jaschawilcox/card-io-hw/frontend/production/frontend_2024-02-06_21-15-05/bom.csv

Designator | Footprint | Quantity | Value | LCSC Part #
C1, C10, C3 | 0603 | 3 | 100n
C11, C12, C13, C14, C15, C17 | 0603 | 6 | 100p
C16 | 0603 | 1 | 1.5n
C2, C4, C7, C8 | 0603 | 4 | 1u
C5, C6 | 0603 | 2 | 4.7n
C9 | 0805 | 1 | 10u
Q1, Q4, Q6 | SOT-23 | 3 | T2N7002AK,LM
Q2, Q3, Q5 | SOT-23 | 3 | NX3008PBK,215
R1, R2, R5, R6 | 0603 | 4 | 2k
R10, R11, R12, R13, R14, R16, R3, R4, R8, R9 | 0603 | 10 | 1M
R15, R7 | 0603 | 2 | 0R
U1 | ADS1291-2 | 1 | ADS1291/2
U2 | KC2016Z | 1 | KC2016Z2
