jaschawilcox/card-io-hw/main_board/main_board.kicad_pcb

## KiCad design main_board/main_board.kicad_pcb (2024-02-07)

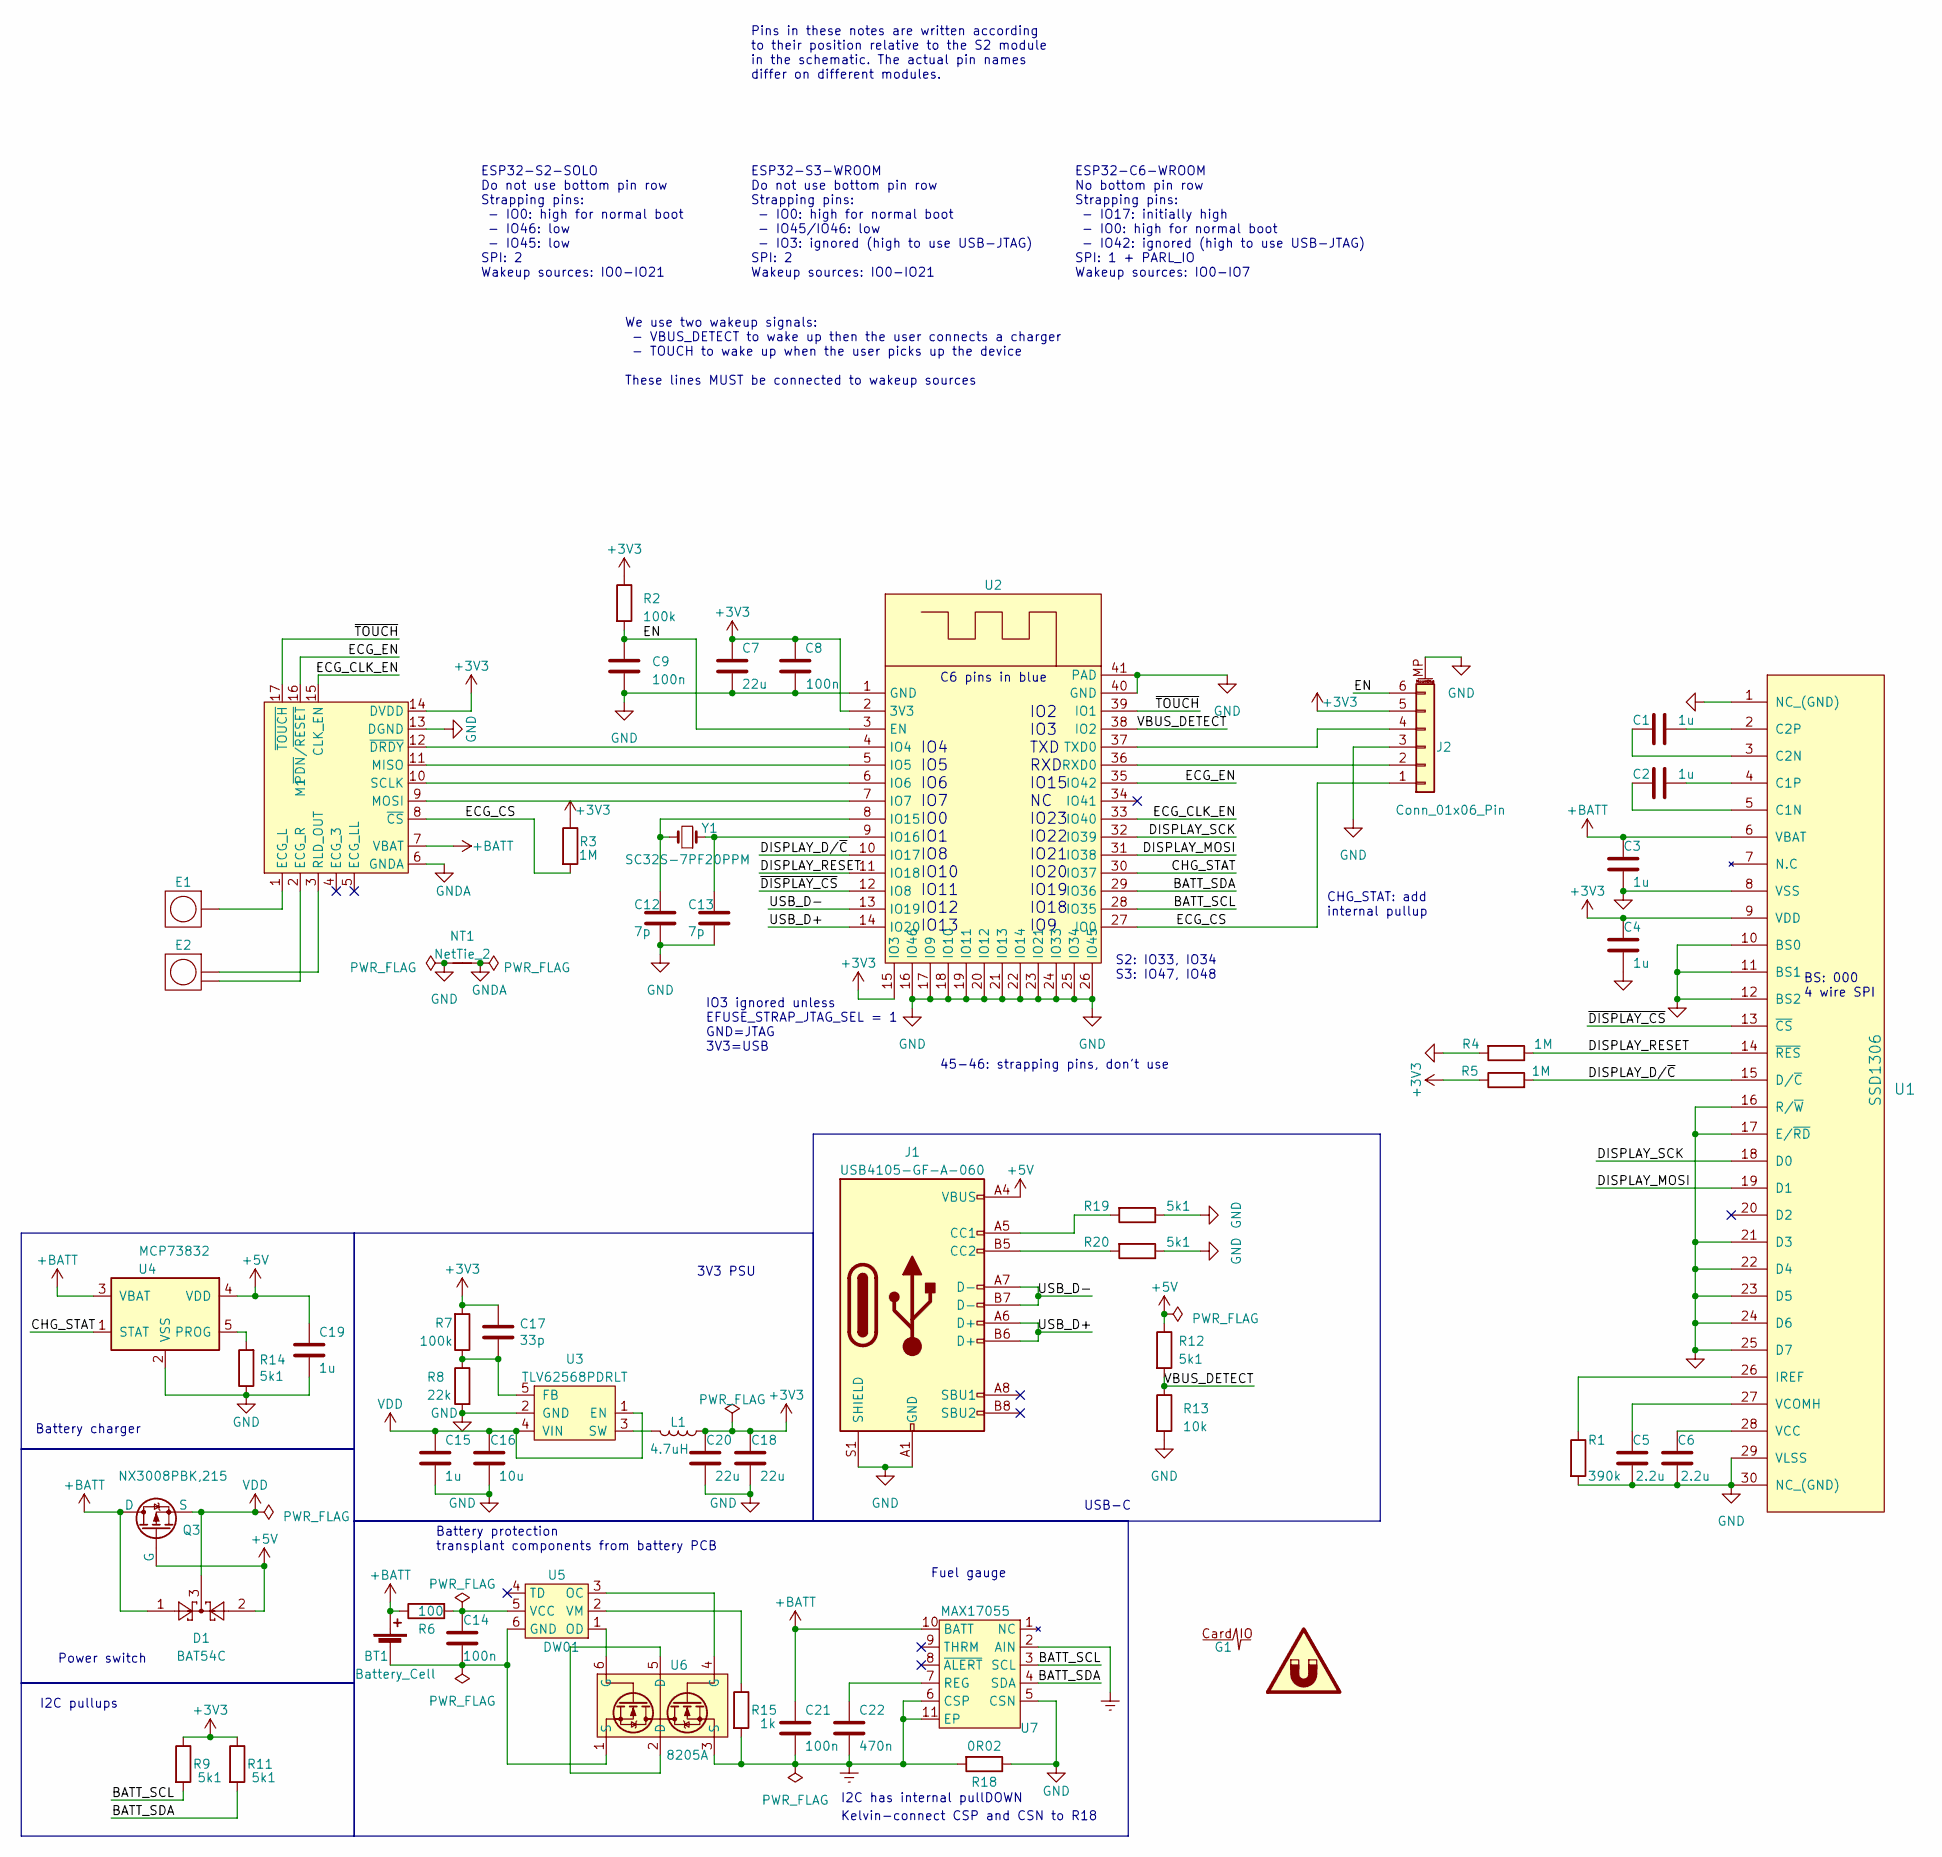
[picture p1: schematic main_board.kicad_sch, Card/IO ECG main board]

Parts:
BT1: Battery_Cell; Battery_transplant
C1, C2, C3, C4, C15, C19: 1u; C_0603_1608Metric; MPN CC0603KRX7R6BB105; LCSC Part # C113807
C5, C6: 2.2u; C_0603_1608Metric; MPN CC0603ZRY5V6BB225; LCSC Part # C106849
C7, C18, C20: 22u; C_0805_2012Metric; MPN CC0603MRX5R6BB226; LCSC Part # C109447
C8, C9, C14, C21: 100n; C_0603_1608Metric; MPN AC0603KRX7R0BB104; LCSC Part # C408909
C12, C13: 7p; C_0603_1608Metric; MPN CC0603DRNPO9BN7R0; LCSC Part # C513583
C16: 10u; C_0603_1608Metric; MPN JMK107ABJ106MA-T; LCSC Part # C268008
C17: 33p; C_0603_1608Metric; MPN CC0603JRNPO9BN330; LCSC Part # C107047
C22: 470n; C_0603_1608Metric; MPN CC0603JRX7R7BB474; LCSC Part # C519558
D1: BAT54C; SOT-23; MPN BAT54C; LCSC Part # C171429
E1: Electrode
E2: SplitElectrode
G1: logo
J1: USB4105-GF-A-060; USB_C_Receptacle_GCT_USB4105-xx-A_16P_TopMnt_Horizontal; MPN USB-TYPE-C-018; LCSC Part # C2927038
J2: Conn_01x06_Pin; Molex_Pico-Clasp_501331-0607_1x06-1MP_P1.00mm_Vertical; MPN 5013310607; LCSC Part # C587861
L1: 4.7uH; TYA40124R7M-10; MPN TYA40124R7M-10; LCSC Part # C2649049
M1: ECG-module_1lead
NT1: NetTie_2; NetTie-2_SMD_Pad2.0mm
Q3: NX3008PBK,215; SOT-23; MPN NX3008PBK,215; LCSC Part # C131670
QR1: SYM_Magnet_Large; website-qr
R1: 390k; R_0603_1608Metric; MPN RC0603FR-07390KL; LCSC Part # C137735
R2, R7: 100k; R_0603_1608Metric; MPN RC0603JR-07100KL; LCSC Part # C100048
R3, R4, R5: 1M; R_0603_1608Metric; MPN RT0603DRD071ML; LCSC Part # C482623
R6: 100; R_0603_1608Metric; MPN RT0603BRD07100RL; LCSC Part # C122970
R8: 22k; R_0603_1608Metric; MPN RC0603FR-0722KL; LCSC Part # C114065
R9, R11, R12, R14, R19, R20: 5k1; R_0603_1608Metric; MPN RT0603FRE075K1L; LCSC Part # C706184
R13: 10k; R_0603_1608Metric; MPN RT0603BRD0710KL; LCSC Part # C95204
R15: 1k; R_0603_1608Metric; MPN RT0603FRE071KL; LCSC Part # C375503
R18: 0R02; R_0603_1608Metric; MPN PE0603FRF570R02L; LCSC Part # C1730619
U1: SSD1306
U2: ESP32-S2-SOLO; MPN ESP32-S2-SOLO-2-N4; LCSC Part # C3040594
U3: TLV62568PDRLT; SOT-23-5; MPN TLV62568PDRLT; LCSC Part # C2071727
U4: MCP73832; SOT-23-5; MPN MCP73832T-2ACI/OT; LCSC Part # C38066
U5: DW01; SOT-23-6; MPN DW01; LCSC Part # C917079
U6: 8205A; SOT-23-6; MPN 8205A; LCSC Part # C2762931
U7: MAX17055; MPN MAX17055ETB+; LCSC Part # C402925
Y1: SC32S-7PF20PPM; Crystal_SMD_MicroCrystal_CC7V-T1A-2Pin_3.2x1.5mm; MPN SC32S-7PF20PPM; LCSC Part # C5452100

Connections:
+3V3: C4.2, C7.1, C8.1, C17.1, C18.1, C20.1, J2.5, L1.1, M1.14 (DVDD), R2.1, R3.1, R5.1, R7.2, R9.1, R11.1, U1.9 (VDD), U2.2 (3V3), U2.15 (IO3)
+5V: C19.1, D1.2, J1.A4 (VBUS), J1.A9 (VBUS), J1.B4 (VBUS), J1.B9 (VBUS), Q3.1 (G), R12.1, U4.4 (VDD)
+BATT: BT1.1 (+), C3.2, C21.1, D1.1, M1.7 (VBAT), Q3.3 (D), R6.1, U1.6 (VBAT), U4.3 (VBAT), U7.10 (BATT)
/BATT_SCL: R9.2, U2.28 (IO35), U7.3 (SCL)
/BATT_SDA: R11.2, U2.29 (IO36), U7.4 (SDA)
/CHG_STAT: U2.30 (IO37), U4.1 (STAT)
/DISPLAY_D/~C: R5.2, U1.15 (D/~C), U2.10 (IO17)
/DISPLAY_MOSI: U1.19 (D1), U2.31 (IO38)
/DISPLAY_RESET: R4.1, U1.14 (~RES), U2.11 (IO18)
/DISPLAY_SCK: U1.18 (D0), U2.32 (IO39)
/ECG_CLK_EN: M1.15 (CLK_EN), U2.33 (IO40)
/ECG_CS: J2.1, M1.8 (~CS), R3.2, U2.27 (IO0)
/ECG_EN: M1.16 (~PDN/~RESET), U2.35 (IO42)
/EN: C9.1, J2.6, R2.2, U2.3 (EN)
/USB_D+: J1.A6 (D+), J1.B6 (D+), U2.14 (IO20)
/USB_D-: J1.A7 (D-), J1.B7 (D-), U2.13 (IO19)
/VBUS_DETECT: R12.2, R13.1, U2.38 (IO2)
/~DISPLAY_CS: U1.13 (~CS), U2.12 (IO8)
/~TOUCH: M1.17 (~TOUCH), U2.39 (IO1)
Earth: C21.2, C22.2, R15.2, R18.2, U6.3 (S), U7.2 (AIN), U7.6 (CSP), U7.11 (EP)
GND: C3.1, C4.1, C5.1, C6.1, C7.2, C8.2, C9.2, C12.1, C13.1, C15.2, C16.2, C18.2, C19.2, C20.2, J1.A1 (GND), J1.A12 (GND), J1.B1 (GND), J1.B12 (GND), J1.S1 (SHIELD), J2.3, J2.MP (MountPin), M1.13 (DGND), NT1.1, R1.2, R4.2, R8.2, R13.2, R14.1, R18.1, R19.1, R20.1, U1.1 (NC_(GND)), U1.8 (VSS), U1.10 (BS0), U1.11 (BS1), U1.12 (BS2), U1.16 (R/~W), U1.17 (E/~RD), U1.21 (D3), U1.22 (D4), U1.23 (D5), U1.24 (D6), U1.25 (D7), U1.29 (VLSS), U1.30 (NC_(GND)), U2.1 (GND), U2.16 (IO46), U2.17 (IO9), U2.18 (IO10), U2.19 (IO11), U2.20 (IO12), U2.21 (IO13), U2.22 (IO14), U2.23 (IO21), U2.24 (IO33), U2.25 (IO34), U2.26 (IO45), U2.40 (GND), U2.41 (PAD), U3.2 (GND), U4.2 (VSS), U7.5 (CSN)
GNDA: M1.6 (GNDA), NT1.2
unnamed: BT1.2 (-), C14.2, U5.6 (GND), U6.1 (S)
unnamed: J1.A5 (CC1), R19.2
unnamed: J1.B5 (CC2), R20.2
unnamed: J2.2, U2.36 (RXD0)
unnamed: J2.4, U2.37 (TXD0)
unnamed: E1.1, M1.1 (ECG_L)
unnamed: E2.2, M1.2 (ECG_R)
unnamed: M1.11 (MISO), U2.5 (IO5)
unnamed: M1.9 (MOSI), U2.7 (IO7)
unnamed: E2.1, M1.3 (RLD_OUT)
unnamed: M1.10 (SCLK), U2.6 (IO6)
unnamed: M1.12 (~DRDY), U2.4 (IO4)
unnamed: C2.1, U1.5 (C1N)
unnamed: C2.2, U1.4 (C1P)
unnamed: C1.1, U1.3 (C2N)
unnamed: C1.2, U1.2 (C2P)
unnamed: R1.1, U1.26 (IREF)
unnamed: C6.2, U1.28 (VCC)
unnamed: C5.2, U1.27 (VCOMH)
unnamed: C12.2, U2.8 (IO15), Y1.2
unnamed: C13.2, U2.9 (IO16), Y1.1
unnamed: C17.2, R7.1, R8.1, U3.5 (FB)
unnamed: L1.2, U3.3 (SW)
unnamed: R14.2, U4.5 (PROG)
unnamed: U5.3 (OC), U6.4 (G)
unnamed: U5.1 (OD), U6.6 (G)
unnamed: C14.1, R6.2, U5.5 (VCC)
unnamed: R15.1, U5.2 (VM)
unnamed: U6.2 (D), U6.5 (D)
unnamed: C22.1, U7.7 (REG)
VDD: C15.1, C16.1, D1.3, Q3.2 (S), U3.1 (EN), U3.4 (VIN)

Notes on the sheet:
IO2 IO3 TXD RXD IO15 NC IO23 IO22 IO21 IO20 IO19 IO18 IO9
IO4 IO5 IO6 IO7 IO0 IO1 IO8 IO10 IO11 IO12 IO13
We use two wakeup signals: - VBUS_DETECT to wake up then the user connects a charger - TOUCH to wake up when the user picks up the device These lines MUST be connected to wakeup sources
C6 pins in blue
USB-C
ESP32-C6-WROOM No bottom pin row Strapping pins: - IO17: initially high - IO0: high for normal boot - IO42: ignored (high to use USB-JTAG) SPI: 1 + PARL_IO Wakeup sources: IO0-IO7
Kelvin-connect CSP and CSN to R18
ESP32-S3-WROOM Do not use bottom pin row Strapping pins: - IO0: high for normal boot - IO45/IO46: low - IO3: ignored (high to use USB-JTAG) SPI: 2 Wakeup sources: IO0-IO21
Battery charger
ESP32-S2-SOLO Do not use bottom pin row Strapping pins: - IO0: high for normal boot - IO46: low - IO45: low SPI: 2 Wakeup sources: IO0-IO21
CHG_STAT: add internal pullup
Pins in these notes are written according to their position relative to the S2 module in the schematic. The actual pin names differ on different modules.
Fuel gauge
3V3 PSU
BS: 000 4 wire SPI
45-46: strapping pins, don't use
I2C has internal pullDOWN
Battery protection transplant components from battery PCB
S2: IO33, IO34 S3: IO47, IO48
I2C pullups
IO3 ignored unless EFUSE_STRAP_JTAG_SEL = 1 GND=JTAG 3V3=USB
Power switch

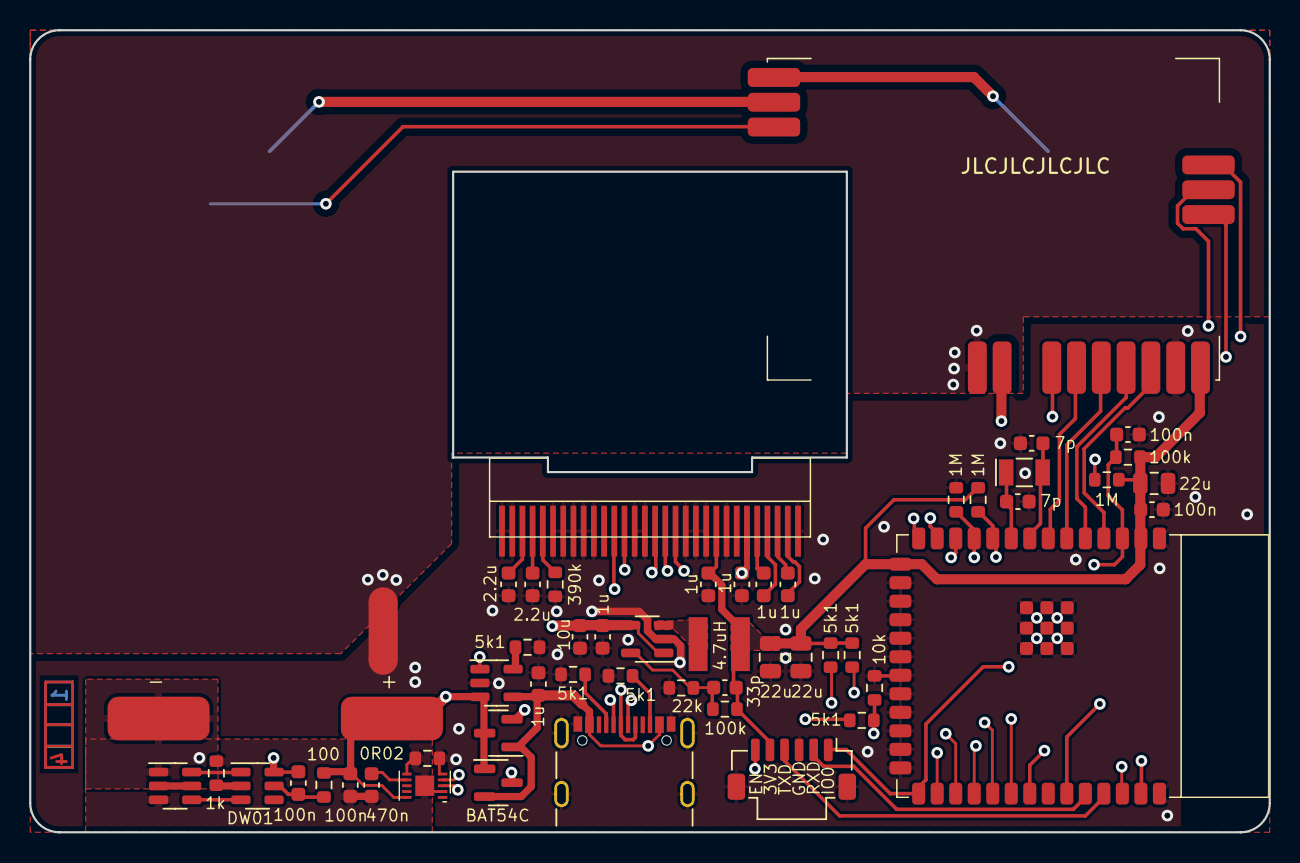
[picture p2: board main_board.kicad_pcb from above]

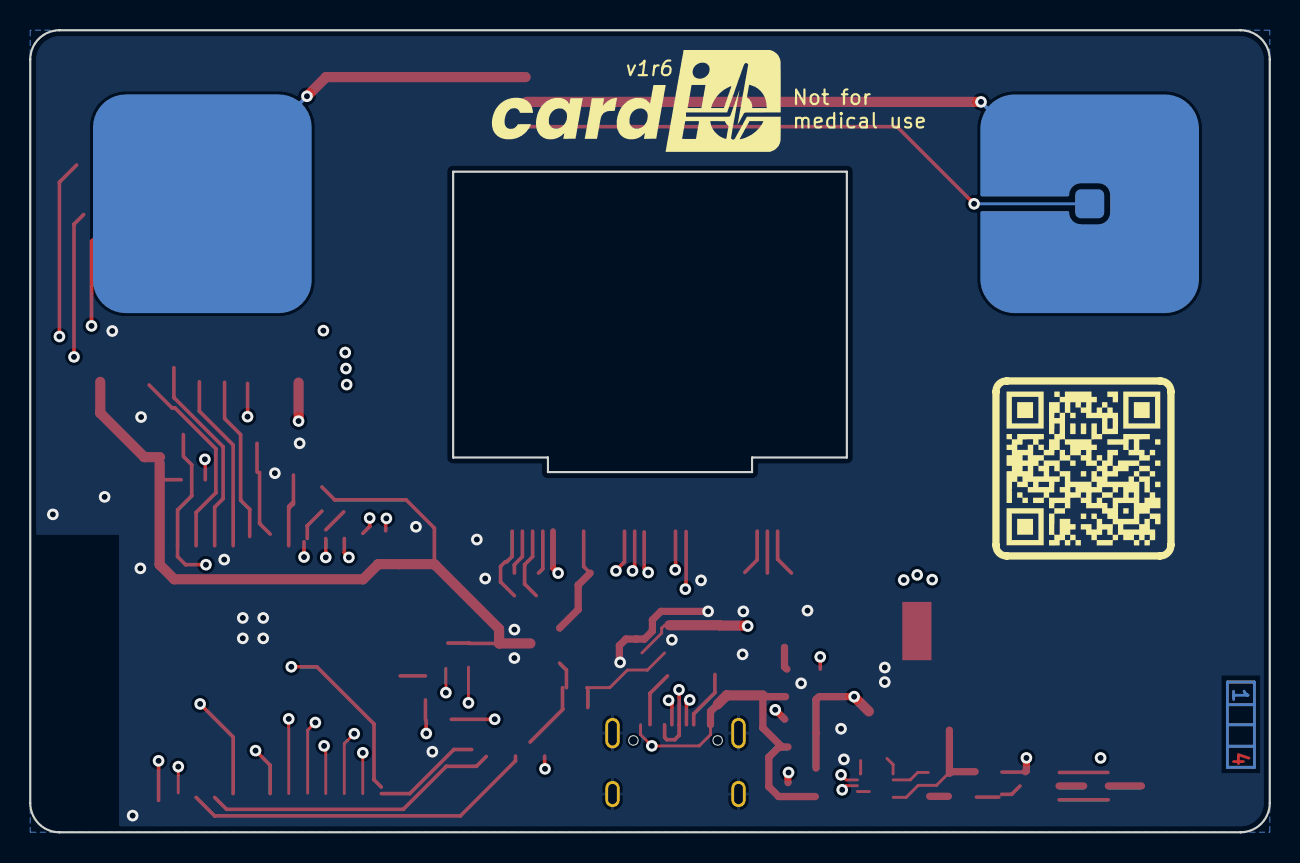
[picture p3: board main_board.kicad_pcb from below]

Board: 4 copper layers, 85.0 x 55.0 mm, 57 parts (4 on the bottom side), 53 nets.
