jaschawilcox/card-io-hw/(commit log)

2024-02-07 Cleanup BOM
    [BOM-main_board.csv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]
2024-02-07 fix package issue on bom
    [bom.csv, designators.csv, main_board.kicad_pcb, main_board.kicad_sch, positions.csv]
2024-05-23 1st prod attempt
    ¯\_(ツ)_/¯
    [bom.csv, designators.csv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]
2024-06-06 add frontend bom, kicad version bump
    [frontend_bom.csv]
